aleh/LSDJmi/(commit log)

2018-03-31 Fix the issue with the LED
    [LSDJmi.ino]
2018-03-31 Add support for calibration byte in EEPROM
2018-04-01 Add support for note velocity config
2018-04-01 Improve README, clean default config and scale the velocities
2018-04-01 Start using oscillator calibration byte
    [LSDJmi.ino]
